donatukas/usdx/IMG_1428.JPG

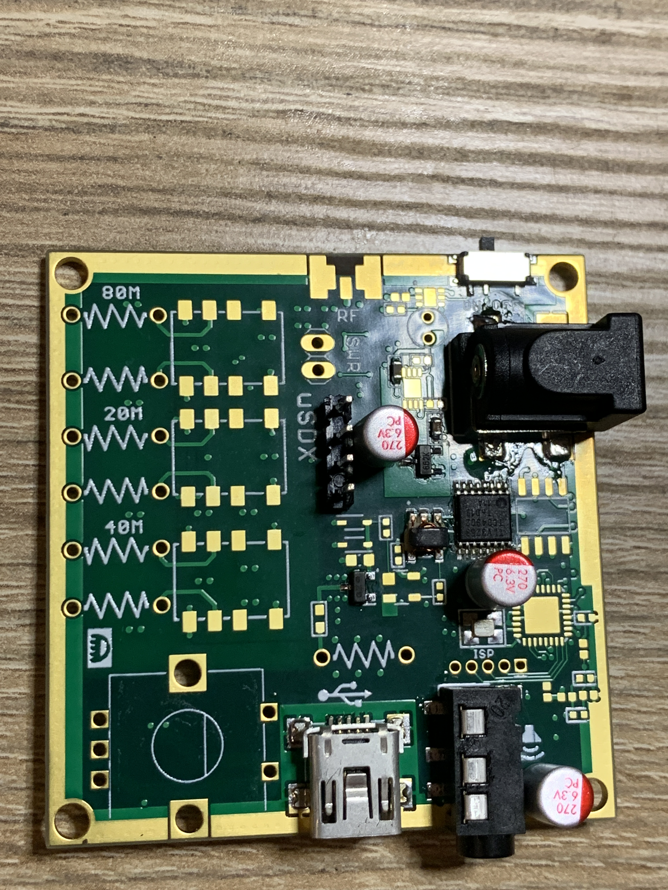
IMG_1428.JPG
