donatukas/usdx/IMG_1429.JPG

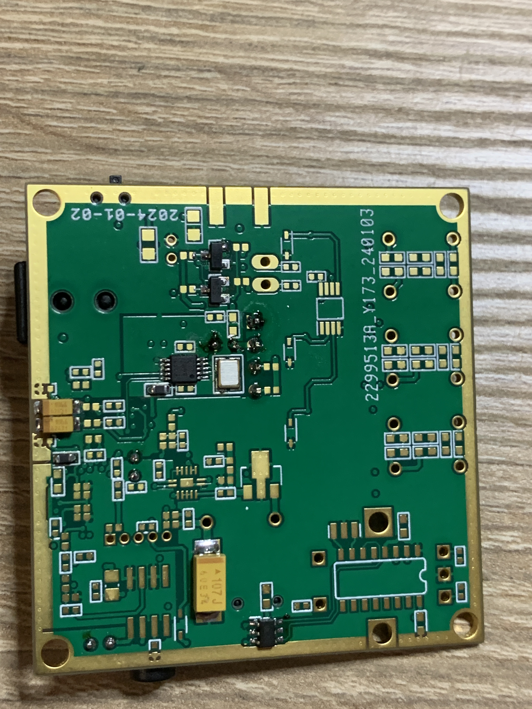
IMG_1429.JPG
