donatukas/usdx/A.png

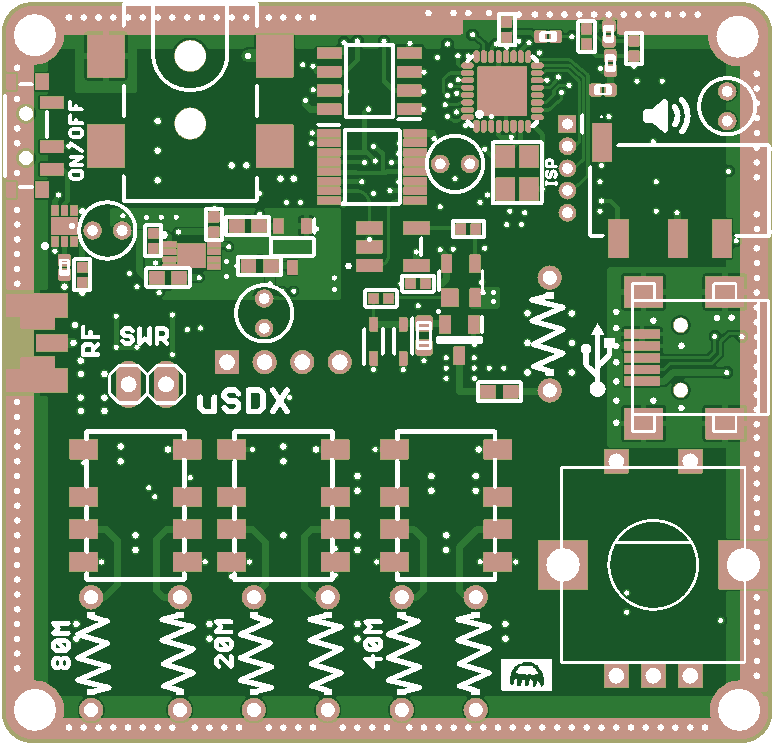
A.png
