donatukas/usdx/B.png

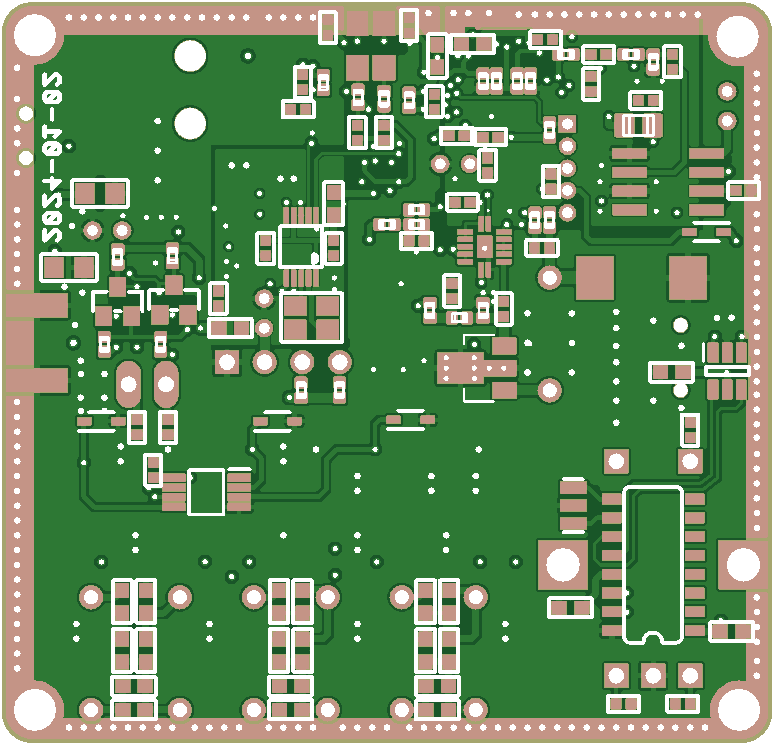
B.png
