donatukas/usdx/usdx.pdf

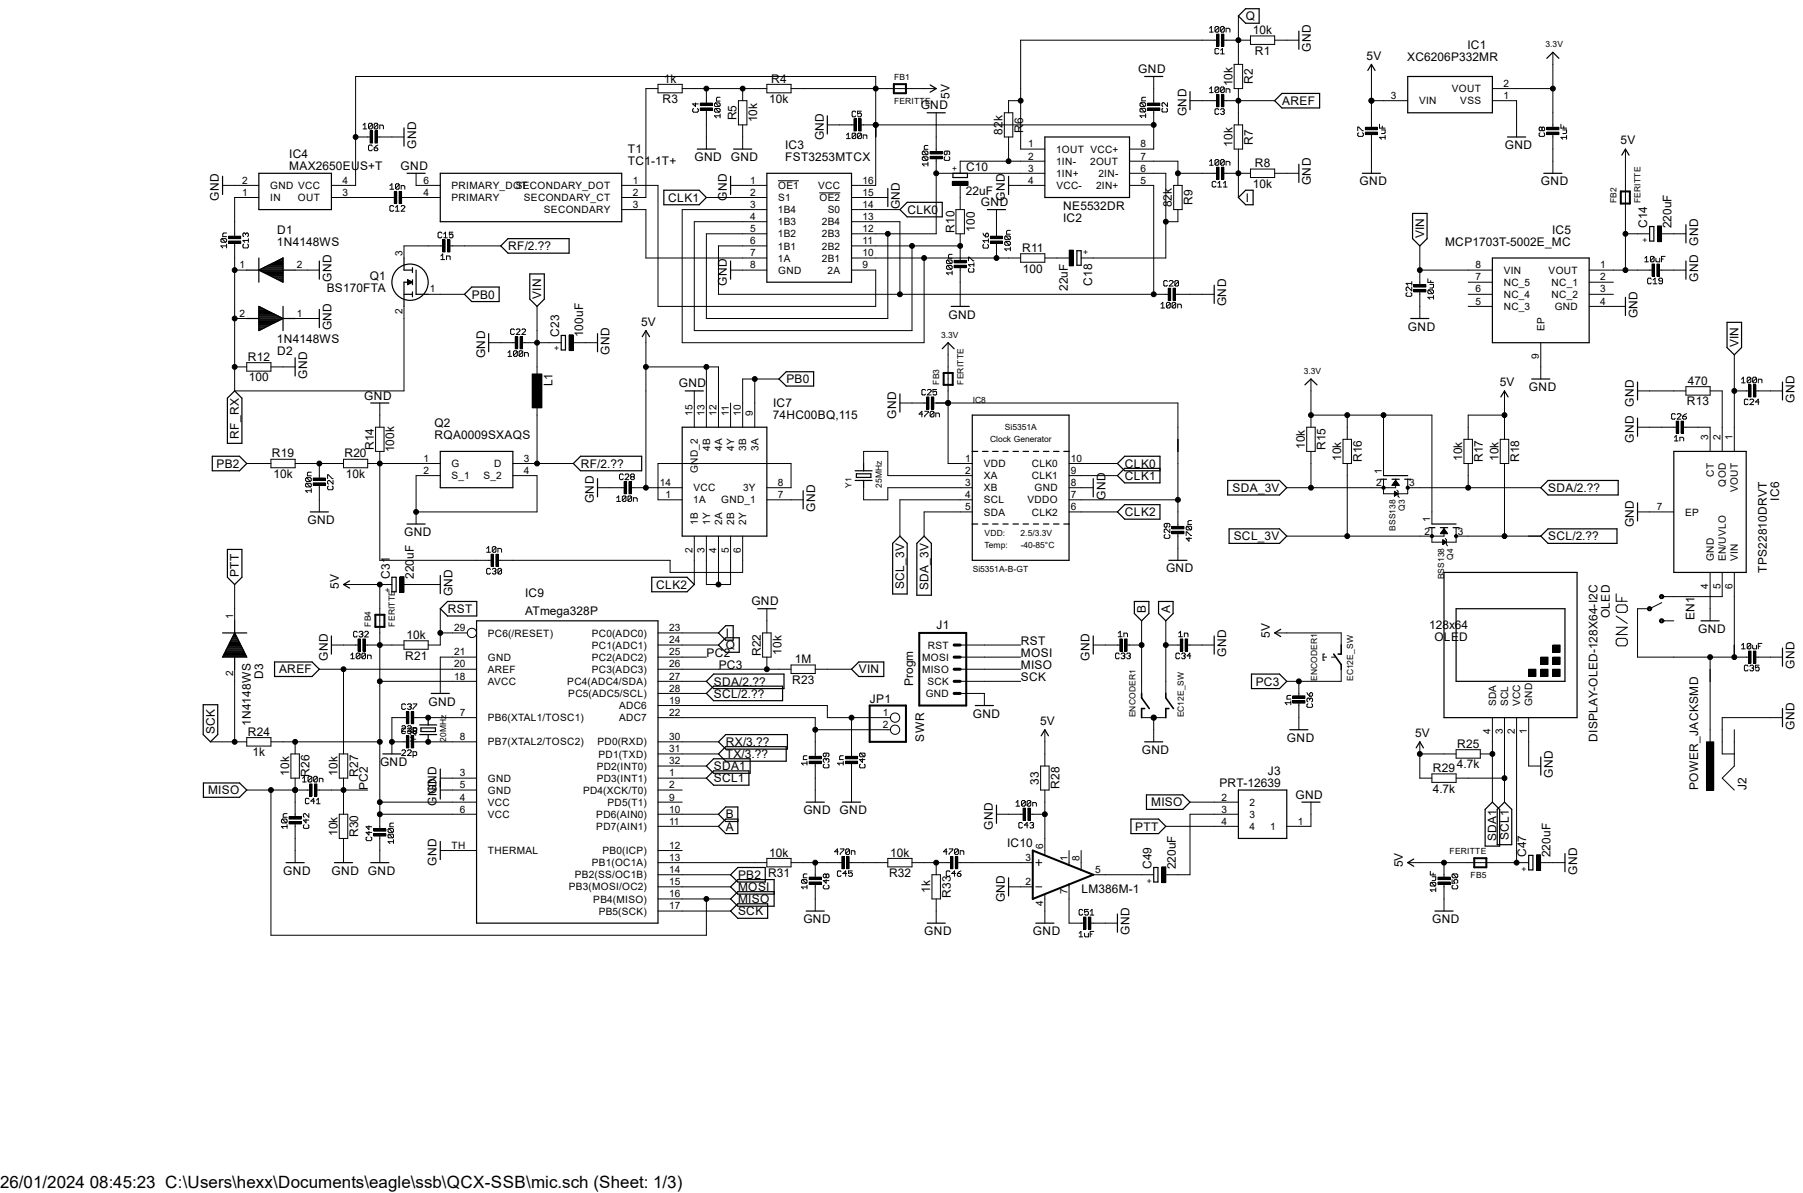
[picture p5: page 1]

7 VDD 1 XA 2 XB 3 SCL 4 SDA 5 CLK2 6 VDDO 7 GND 8 CLK1 9 CLK0 10

26/01/2024 08:45:23 C:\Users\hexx\Documents\eagle\ssb\QCX-SSB\mic.sch (Sheet: 1/3)

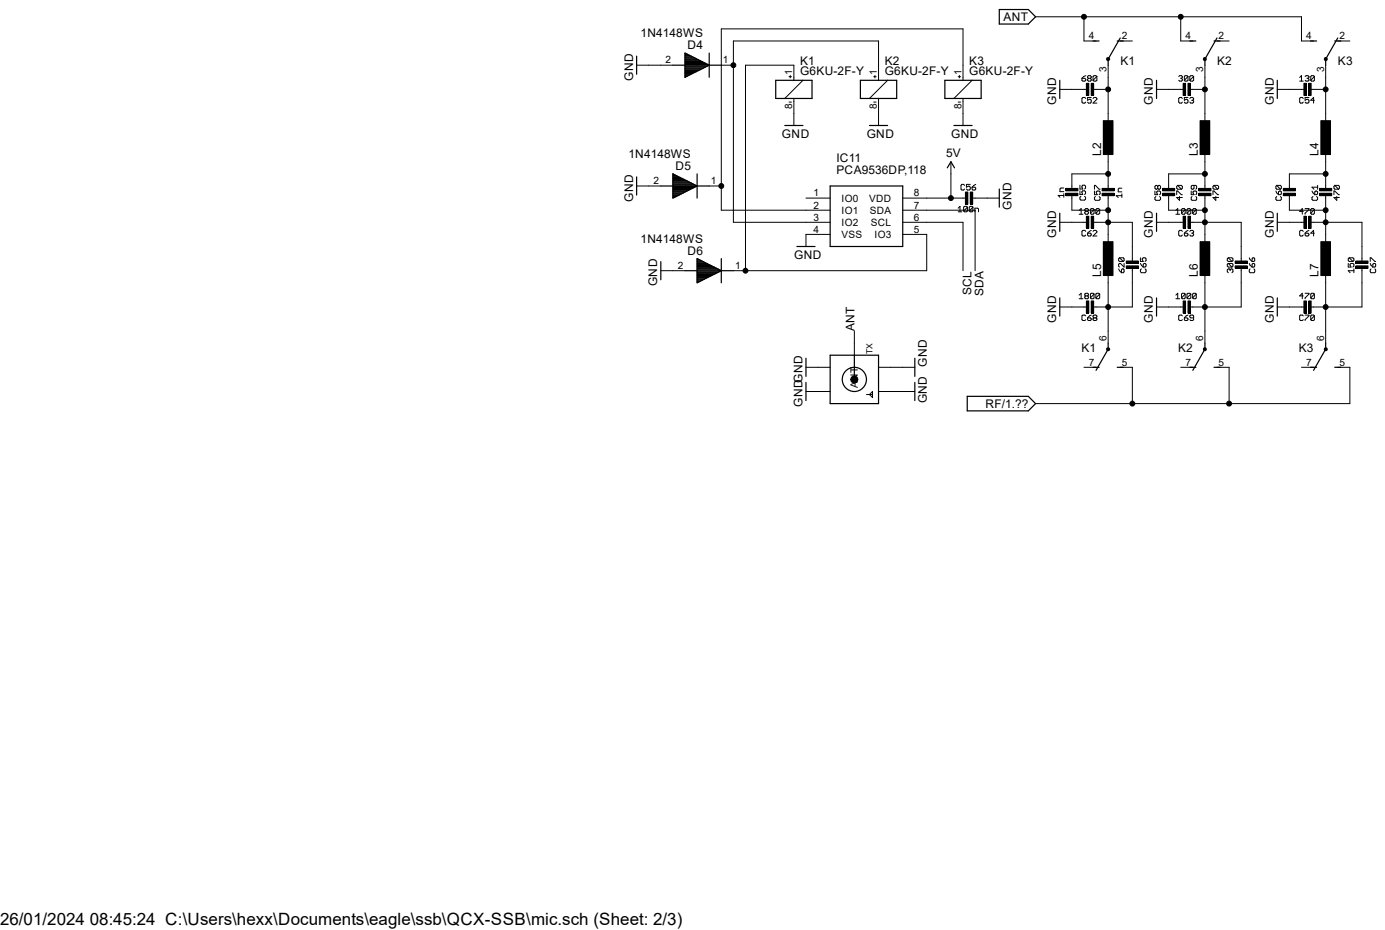
[picture p6: page 2]
GND GND GND; PCA9536DP,118; GND; GND GND GND GND; 1N4148WS GND; VSS 4; VDD; 8 SDA; 7 SCL; IC11ANT TX; ANT ANT; RF/1.?? SCL SDA

26/01/2024 08:45:24 C:\Users\hexx\Documents\eagle\ssb\QCX-SSB\mic.sch (Sheet: 2/3)

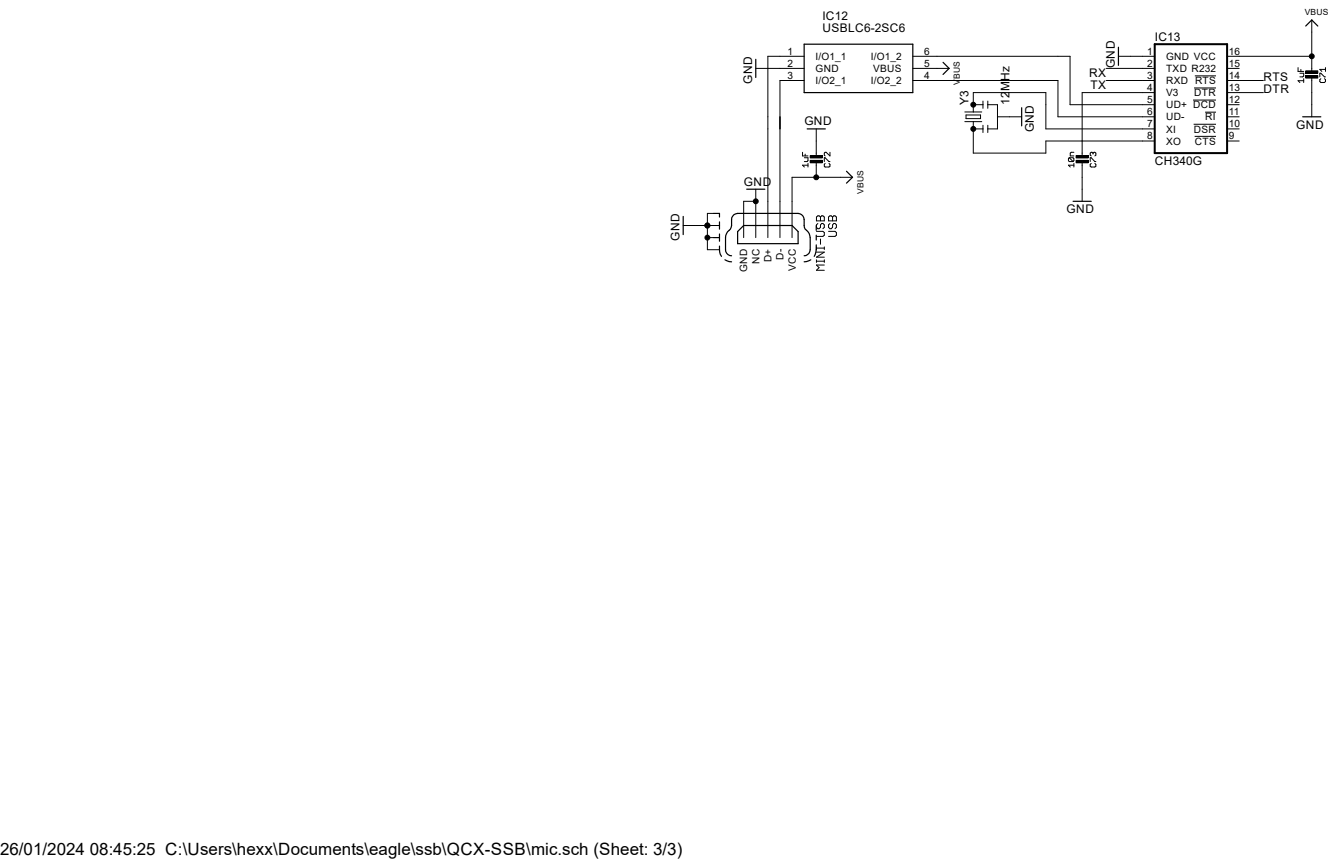
[picture p7: page 3]
CH340G ¹²MHz; GND GND; GND; VBUS GND; VBUS; USBLC6-2SC6 GND; IC13GND 1; TXD 2; RXD 3; CTS; 9 DSR; 11 DCD; 12 DTR; 13 RTS; 15 VCC; 16 Y³ VCCD⁺D⁻ NC GND; GND 2; 6 VBUS; DTR; RTS

26/01/2024 08:45:25 C:\Users\hexx\Documents\eagle\ssb\QCX-SSB\mic.sch (Sheet: 3/3)
