donatukas/usdx/mic.brd

## EAGLE design mic.brd (2024-01-26)

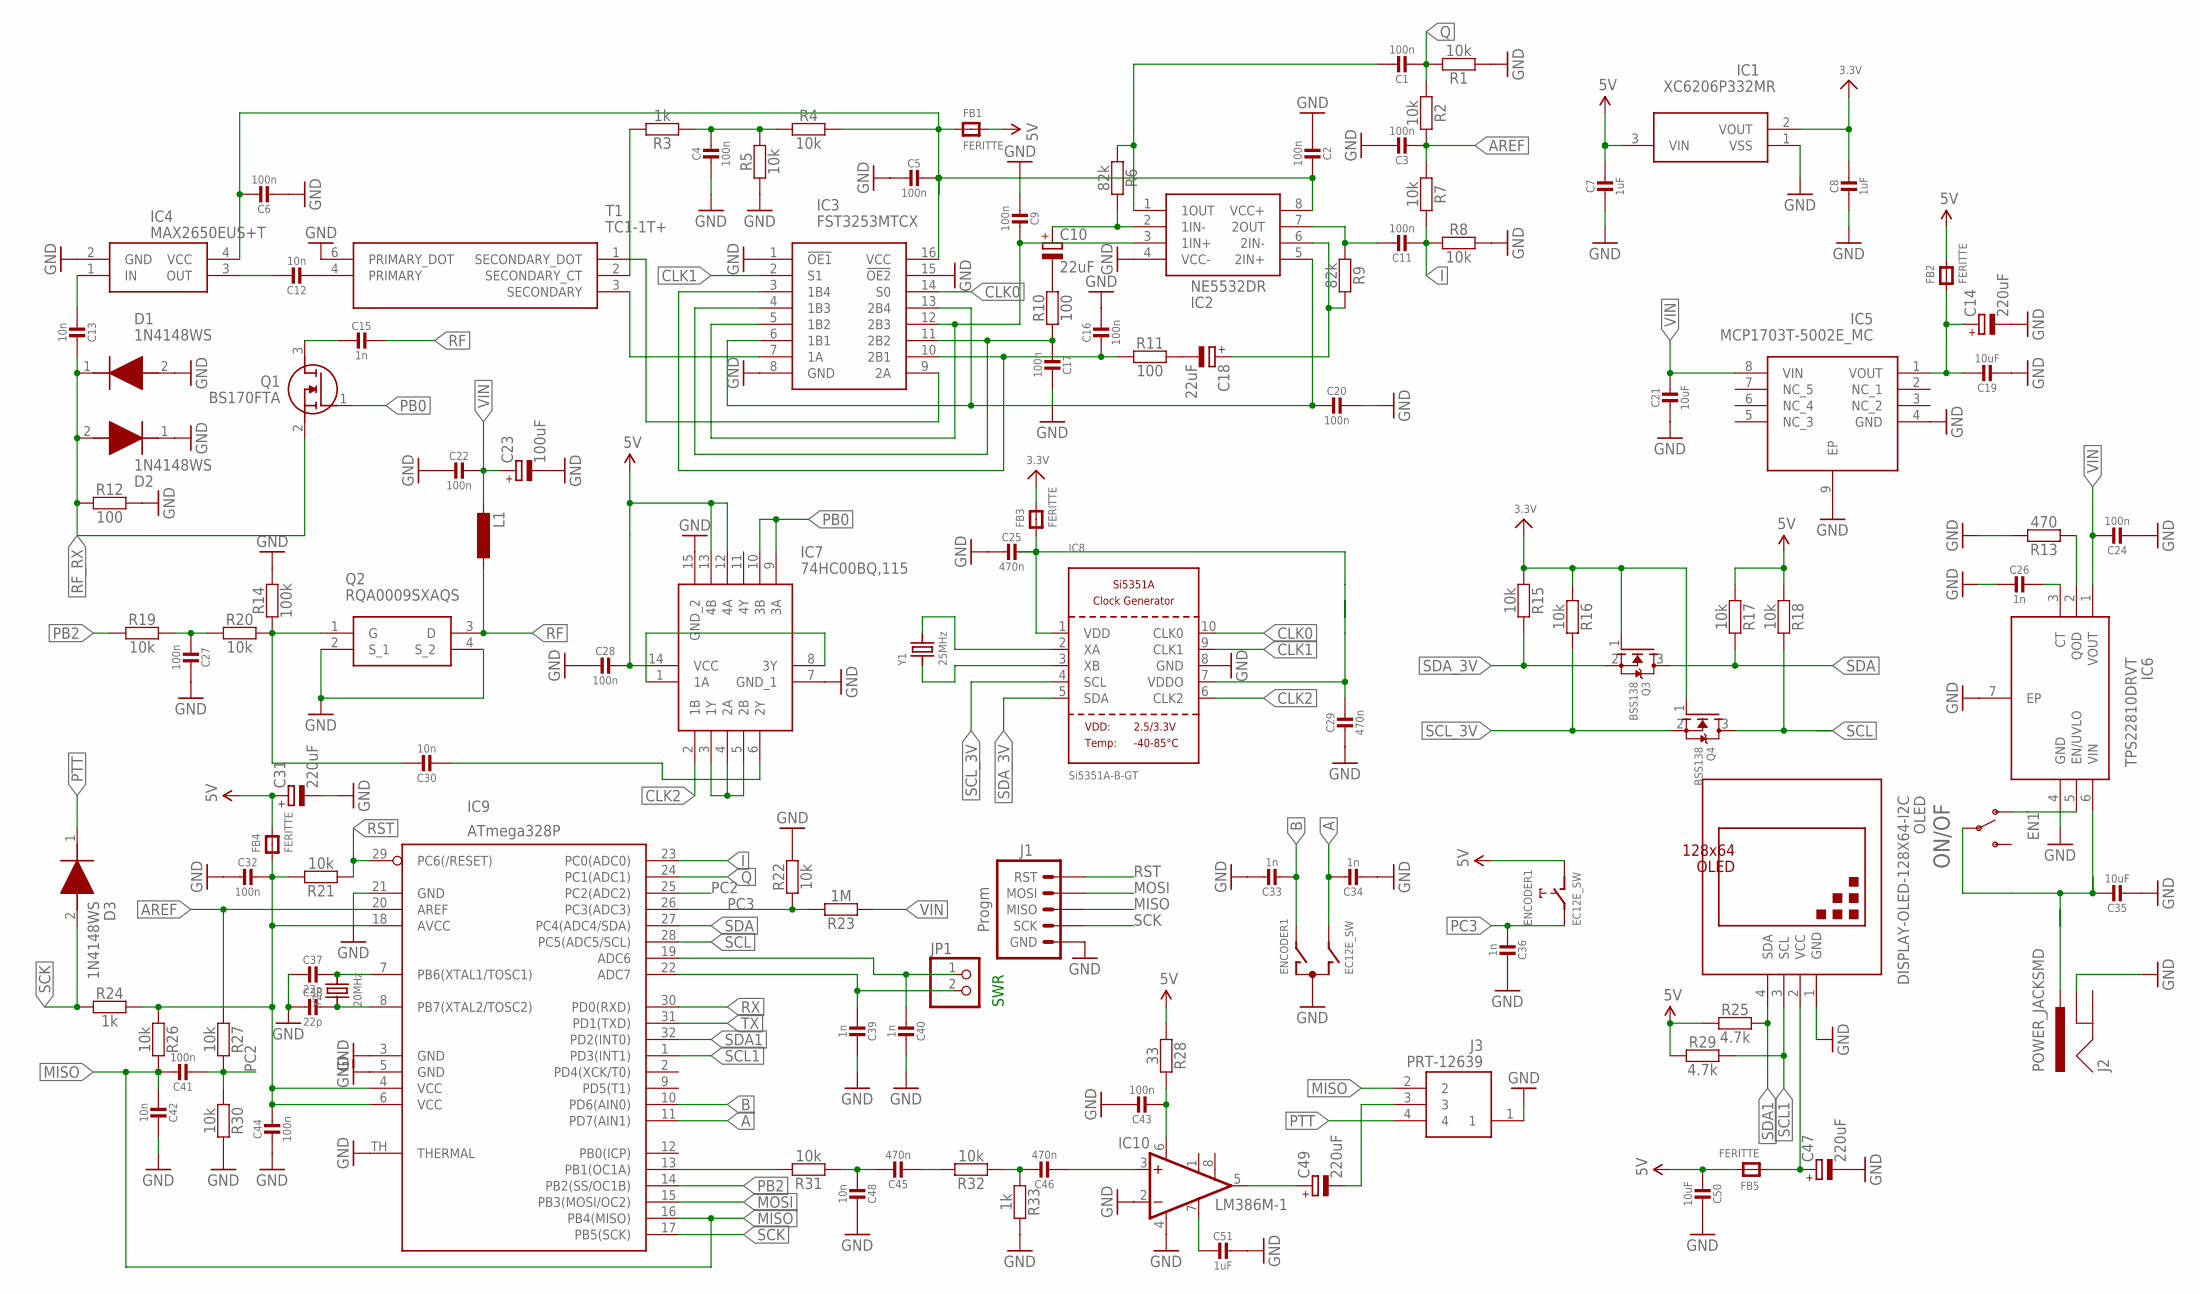
[picture p8: schematic mic.sch, sheet 1]

Parts:
C1, C2, C3, C4, C5, C6, C9, C11, C16, C17, C20, C22, C27, C28, C32, C41, C43, C44: 100n; _0402
C7, C8: 1uF; _0603
C10, C18: 22uF; SMC_A
C12, C13, C30, C42, C48: 10n; _0402
C14, C31, C47, C49: 220uF; SANYO-OSCON_A
C15: 1n; _0603
C19, C21, C50: 10uF; _0402
C23: 100uF; SMC_D
C24: 100n; _0805
C25, C29, C45, C46: 470n; _0402
C26, C33, C34, C36, C39, C40: 1n; _0402
C35: 10uF; _0805
C37, C38: 22p; _0402
C51: 1uF; _0402
D1: 1N4148WS; SODFL2512X90N
D2, D3: 1N4148WS; SODFL2512X90N; MANUFACTURER_PART_NUMBER 1N4148WS; MOUSER_PART_NUMBER 512-1N4148WS
ENCODER1: EC12E_SW; ALPS_EC12E_SW; MPN EC12E2424407
FB1, FB2, FB3, FB4, FB5: FERITTE; _0603
IC1: XC6206P332MR; SOT95P280X130-3N
IC2: NE5532DR; SOIC127P600X175-8N
IC3: FST3253MTCX; SOP65P640X110-16N
IC4: MAX2650EUS+T; 4-SOT143
IC5: MCP1703T-5002E_MC; SON50P300X200X100-9N
IC6: TPS22810DRVT; SON65P200X200X80-7N
IC7: 74HC00BQ,115; 74HC00BQ115
IC8: Si5351A-B-GT; MSOP10
IC9: ATmega328P; MLF32-TH
IC10: LM386M-1; SO08
J1: Progm; SPARKFUN-CONNECTORS_PIC-ICSP-MINI
J2: POWER_JACKSMD; POWER_JACK_SMD
J3: PRT-12639; PRT12639
JP1: PINHD-1X2; 1X02
L1: RCL_L-EUTFI0305; RCL_TFI0305
OLED: DISPLAY-OLED-128X64-I2C; NEW_DIY-MODULES_(1)_DISPLAY-OLED-128X64-I2C
ON/OF: SWITCH-SPDT-SMD-RIGHT-ANGLE; SWITCH_SPST_SMD_A
Q1: BS170FTA; SOT96P240X100-3N
Q2: RQA0009SXAQS
Q3, Q4: BSS138; SOT23-WIDE
R1, R2, R4, R5, R7, R8, R15, R16, R17, R18, R19, R20, R21, R22, R26, R27, R30, R31, R32: 10k; C0402
R3, R24, R33: 1k; C0402
R6, R9: 82k; C0402
R10, R11: 100; C0402
R12: 100; C0603
R13: 470; C0402
R14: 100k; C0402
R23: 1M; C0402
R25, R29: 4.7k; C0402
R28: 33; C0805
T1: TC1-1T+; TC11T
Y1: 25MHz; CRYSTAL_3.2X2.5
Y2: 20MHz; CRYSTAL_3.2X2.5

Connections:
5V: C7.1, C28.1, C31.+, C50.2, ENCODER1.D (1), FB1.2, FB2.2, FB4.2, FB5.2, IC1.3 (VIN), IC7.12 (4A), IC7.13 (4B), IC7.14 (VCC), R17.2, R18.2, R25.2, R28.2, R29.2; also elsewhere on the board
A: C34.1, ENCODER1.B, IC9.11 (PD7(AIN1))
AREF: C3.2, IC9.20 (AREF), R2.1, R7.2, R27.2
B: C33.2, ENCODER1.A, IC9.10 (PD6(AIN0))
CLK0: IC3.14 (S0), IC8.10 (CLK0)
CLK1: IC3.2 (S1), IC8.9 (CLK1)
CLK2: IC7.2 (1B), IC8.6 (CLK2)
EN1: IC6.5 (EN/UVLO), ON/OF.1 (O)
GND: C2.2, C3.1, C4.2, C5.2, C6.2, C7.2, C8.2, C9.2, C14.-, C16.1, C17.1, C19.2, C20.1, C21.2, C22.2, C23.-, C24.2, C25.2, C26.2, C27.1, C28.2, C29.2, C31.-, C32.2, C33.1, C34.2, C35.2, C36.1, C37.2, C38.2, C39.1, C40.1, C42.1, C43.1, C44.2, C47.-, C48.1, C50.1, C51.1, D1.2 (A), D2.1 (K), ENCODER1.C, IC1.1 (VSS), IC2.4 (VCC-), IC3.1 (!OE1), IC3.8 (GND), IC3.15 (!OE2), IC4.2 (GND), IC5.4 (GND), IC5.9 (EP), IC6.4 (GND), IC6.7 (EP), IC7.7 (GND_1), IC7.15 (GND_2), IC8.8 (GND), IC9.3 (GND), IC9.5 (GND), IC9.21 (GND), IC9.TH (THERMAL), IC10.2 (-IN), IC10.4 (GND), J1.5 (GND), J2.GND (GNDBREAK), J3.1, OLED.1 (GND), Q2.2 (S_1), Q2.4 (S_2), R1.2, R5.2, R8.1, R12.1, R13.2, R14.1, R22.1, R30.1, R33.1, T1.6 (PRIMARY_DOT); also elsewhere on the board
I: C11.2, IC9.23 (PC0(ADC0)), R7.1, R8.2
MISO: C41.1, C42.2, IC9.16 (PB4(MISO)), J1.3 (MISO), J3.2, R26.1
MOSI: IC9.15 (PB3(MOSI/OC2)), J1.2 (MOSI)
unnamed: IC7.3 (1Y), IC7.4 (2A), IC7.5 (2B)
unnamed: IC3.7 (1A), T1.3 (SECONDARY)
unnamed: C47.+, FB5.1, OLED.2 (VCC)
unnamed: C37.1, IC9.7 (PB6(XTAL1/TOSC1)), Y2.2
unnamed: C38.1, IC9.8 (PB7(XTAL2/TOSC2)), Y2.1
unnamed: IC3.9 (2A), T1.1 (SECONDARY_DOT)
unnamed: C4.1, R3.2, R4.2, R5.1
unnamed: IC7.1 (1A), IC7.8 (3Y)
unnamed: C30.2, IC7.6 (2Y)
unnamed: C30.1, Q2.1 (G), R14.2, R20.1
unnamed: C27.2, R19.1, R20.2
unnamed: C26.1, IC6.3 (CT)
unnamed: C20.2, IC2.5 (2IN+), IC3.6 (1B1), IC3.13 (2B4)
unnamed: C9.1, IC2.3 (1IN+), IC3.5 (1B2), IC3.12 (2B3)
unnamed: R3.1, T1.2 (SECONDARY_CT)
unnamed: C17.2, IC3.4 (1B3), IC3.11 (2B2), R10.2
unnamed: C16.2, IC3.3 (1B4), IC3.10 (2B1), R11.2
unnamed: C1.1, IC2.1 (1OUT), R6.2
unnamed: IC9.13 (PB1(OC1A)), R31.1
unnamed: C45.1, C48.2, R31.2
unnamed: C11.1, IC2.7 (2OUT), R9.2
unnamed: C18.-, R11.1
unnamed: C18.+, IC2.6 (2IN-), R9.1
unnamed: C10.+, IC2.2 (1IN-), R6.1
unnamed: C10.-, R10.1
unnamed: C45.2, R32.1
unnamed: C46.1, R32.2, R33.2
unnamed: C32.1, C44.1, FB4.1, IC9.4 (VCC), IC9.6 (VCC), IC9.18 (AVCC), R21.1, R24.1, R26.2
unnamed: C46.2, IC10.3 (+IN)
unnamed: C43.2, IC10.6 (VS), R28.1
unnamed: C51.2, IC10.7 (BYPASS)
unnamed: C49.+, IC10.5 (OUT)
unnamed: C49.-, J3.3
unnamed: C12.2, T1.4 (PRIMARY)
unnamed: C12.1, IC4.3 (OUT)
unnamed: C13.2, IC4.1 (IN)
unnamed: C15.2, Q1.3 (D)
unnamed: C14.+, C19.1, FB2.1, IC5.1 (VOUT)
unnamed: C2.1, C5.1, C6.1, FB1.1, IC2.8 (VCC+), IC3.16 (VCC), IC4.4 (VCC), R4.1
unnamed: IC8.3 (XB), Y1.1
unnamed: IC8.2 (XA), Y1.2
unnamed: IC6.2 (QOD), R13.1
unnamed: C25.1, C29.1, FB3.1, IC8.1 (VDD), IC8.7 (VDDO)
unnamed: C40.2, IC9.19 (ADC6), JP1.1
unnamed: C39.2, IC9.22 (ADC7), JP1.2
PB0: IC7.9 (3A), IC7.10 (3B), Q1.1 (G)
PB2: IC9.14 (PB2(SS/OC1B)), R19.2
PC2: C41.2, IC9.25 (PC2(ADC2)), R27.1, R30.2
PC3: C36.2, ENCODER1.E (2), IC9.26 (PC3(ADC3)), R22.2, R23.1
PTT: D3.1 (K), J3.4
Q: C1.2, IC9.24 (PC1(ADC1)), R1.1, R2.2
RF: C15.1, L1.1, Q2.3 (D); also elsewhere on the board
RF_RX: C13.1, D1.1 (K), D2.2 (A), Q1.2 (S), R12.2
RST: IC9.29 (PC6(/RESET)), J1.1 (RST), R21.2
RX: IC9.30 (PD0(RXD)); also elsewhere on the board
SCK: D3.2 (A), IC9.17 (PB5(SCK)), J1.4 (SCK), R24.2
SCL: IC9.28 (PC5(ADC5/SCL)), Q4.3 (D), R18.1; also elsewhere on the board
SCL1: IC9.1 (PD3(INT1)), OLED.3 (SCL), R29.1
SCL_3V: IC8.4 (SCL), Q4.2 (S), R16.1
SDA: IC9.27 (PC4(ADC4/SDA)), Q3.3 (D), R17.1; also elsewhere on the board
SDA1: IC9.32 (PD2(INT0)), OLED.4 (SDA), R25.1
SDA_3V: IC8.5 (SDA), Q3.2 (S), R15.1
TX: IC9.31 (PD1(TXD)); also elsewhere on the board
VDD: C8.1, FB3.2, IC1.2 (VOUT), Q3.1 (G), Q4.1 (G), R15.2, R16.2
VIN: C21.1, C22.1, C23.+, C24.1, IC5.8 (VIN), IC6.1 (VOUT), L1.2, R23.2
VIN1: C35.1, IC6.6 (VIN), J2.VIN0 (PWR), ON/OF.2

Notes on the sheet:
SWR

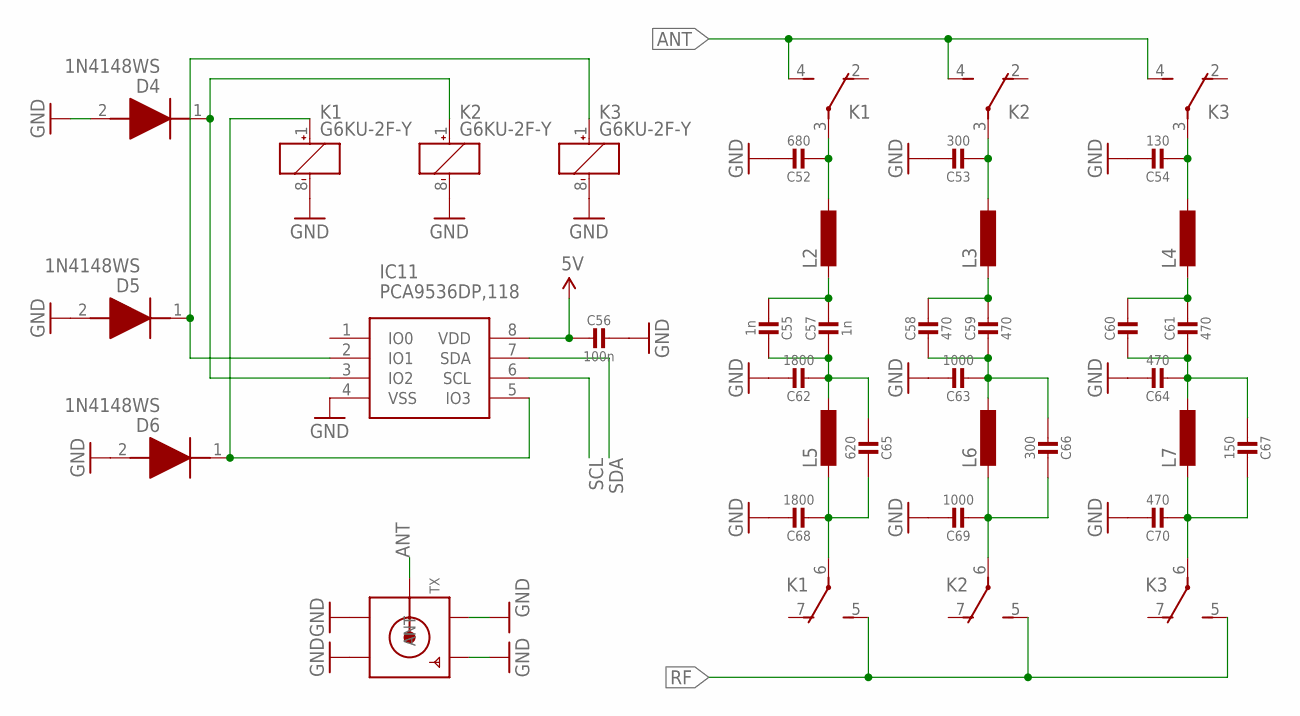
[picture p9: schematic mic.sch, sheet 2]

Parts:
C52: 680; _0603
C53, C66: 300; _0603
C54: 130; _0603
C55, C57: 1n; _0603
C56: 100n; _0402
C58, C59, C61, C64, C70: 470; _0603
C60: CAP_CERAMIC_0603; _0603
C62, C68: 1800; _0603
C63, C69: 1000; _0603
C65: 620; _0603
C67: 150; _0603
D4, D5: 1N4148WS; SODFL2512X90N; MANUFACTURER_PART_NUMBER 1N4148WS; MOUSER_PART_NUMBER 512-1N4148WS
D6: 1N4148WS; SODFL2512X90N
IC11: PCA9536DP,118; SOP65P490X110-8N
K1: G6KU-2F-Y
K2, K3: G6KU-2F-Y; MPN G6KU-2F-Y DC3
L2, L3, L4, L5, L6, L7: RCL_L-EUTFI0305; RCL_TFI0305
TX: MODULATOR_MICROBUILDER_SMACONNECTOR_EDGE_UFL; MODULATOR_MICROBUILDER_SMA_EDGELAUNCH_UFL

Connections:
5V: C56.2, IC11.8 (VDD); also elsewhere on the board
ANT: K1.4 (S), K2.4 (S), K3.4 (S), TX.P (ANT)
GND: C52.1, C53.1, C54.1, C56.1, C62.1, C63.1, C64.1, C68.1, C69.1, C70.1, D4.2 (A), D5.2 (A), D6.2 (A), IC11.4 (VSS), K1.8 (-), K2.8 (-), K3.8 (-), TX.GND@1 (GND1), TX.GND@2 (GND2), TX.GND@3 (GND3), TX.GND@4 (GND4); also elsewhere on the board
unnamed: C55.2, C57.1, L2.2
unnamed: C55.1, C57.2, C62.2, C65.2, L5.1
unnamed: C58.1, C59.1, L3.2
unnamed: C52.2, K1.3, L2.1
unnamed: C53.2, K2.3, L3.1
unnamed: C54.2, K3.3, L4.1
unnamed: C67.1, C70.2, K3.6, L7.2
unnamed: C66.1, C69.2, K2.6, L6.2
unnamed: C65.1, C68.2, K1.6, L5.2
unnamed: C58.2, C59.2, C63.2, C66.2, L6.1
unnamed: C60.2, C61.2, C64.2, C67.2, L7.1
unnamed: C60.1, C61.1, L4.2
unnamed: D6.1 (K), IC11.5 (IO3), K1.1 (+)
unnamed: D4.1 (K), IC11.3 (IO2), K2.1 (+)
unnamed: D5.1 (K), IC11.2 (IO1), K3.1 (+)
RF: K1.5 (S), K2.5 (S), K3.5 (S); also elsewhere on the board
SCL: IC11.6 (SCL); also elsewhere on the board
SDA: IC11.7 (SDA); also elsewhere on the board

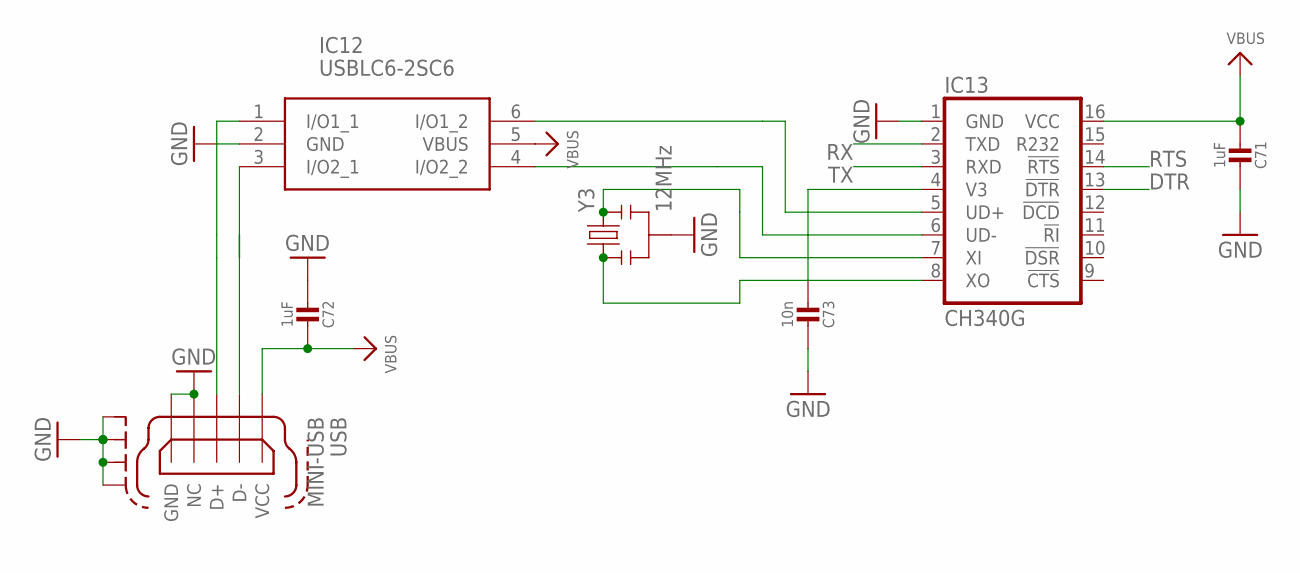
[picture p10: schematic mic.sch, sheet 3]

Parts:
C71, C72: 1uF; _0603
C73: 10n; _0603
IC12: USBLC6-2SC6; SOT95P280X145-6N
IC13: CH340G; SO016
USB: MINI-USB; MINI-USB-B5
Y3: 12MHz; RESONATOR-SMD

Connections:
DTR: IC13.13 (!DTR)
GND: C71.1, C72.2, C73.1, IC12.2 (GND), IC13.1 (GND), USB.4 (NC), USB.5 (GND), USB.M1 (S1), USB.M2 (S2), USB.M3 (S3), USB.M4 (S4), Y3.2; also elsewhere on the board
unnamed: IC12.6 (I/O1_2), IC13.5 (UD+)
unnamed: IC12.4 (I/O2_2), IC13.6 (UD-)
unnamed: IC13.8 (XO), Y3.1
unnamed: IC13.7 (XI), Y3.3
unnamed: IC12.1 (I/O1_1), USB.3 (D+)
unnamed: IC12.3 (I/O2_1), USB.2 (D-)
RTS: IC13.14 (!RTS)
RX: IC13.2 (TXD); also elsewhere on the board
TX: IC13.3 (RXD); also elsewhere on the board
V3: C73.2, IC13.4 (V3)
VBUS: C71.2, C72.1, IC12.5 (VBUS), IC13.16 (VCC), USB.1 (VCC)

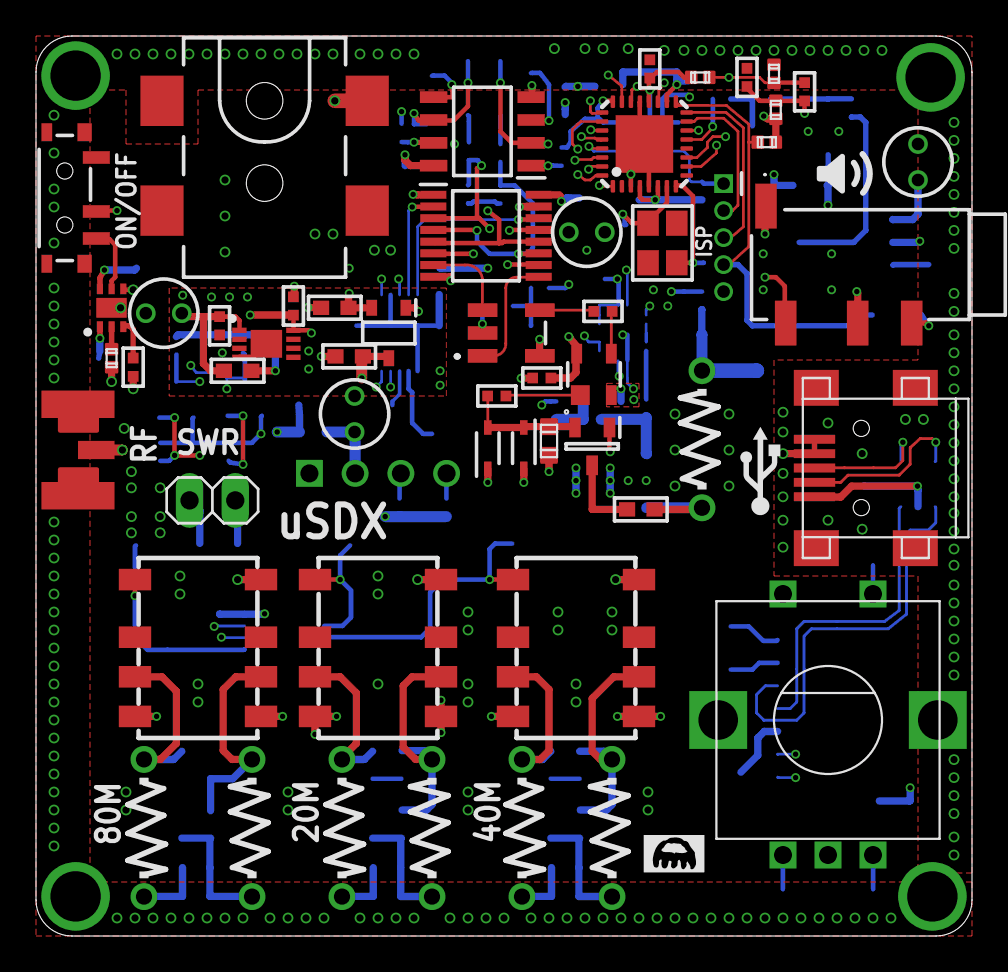
[picture p11: board mic.brd from above]

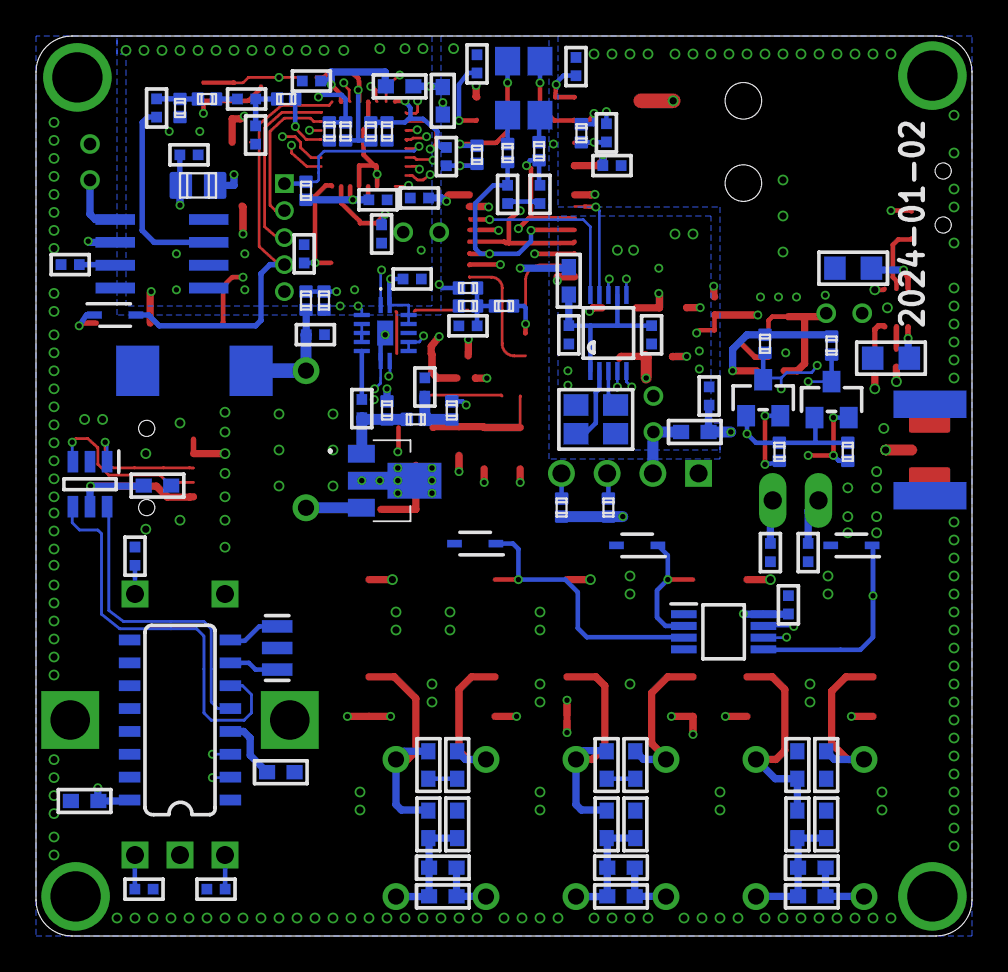
[picture p12: board mic.brd from below]

Board: 6 copper layers, 52.0 x 50.0 mm, 157 parts (103 on the bottom side), 102 nets.
